jackmday-uofa/compact-shredder-pcb/README.md

# compact-shredder-pcb
PCB schematic and design for the Compact Shredder Design Version 2
