jackmday-uofa/compact-shredder-pcb/shredder_pcb/v1 schematic.pdf

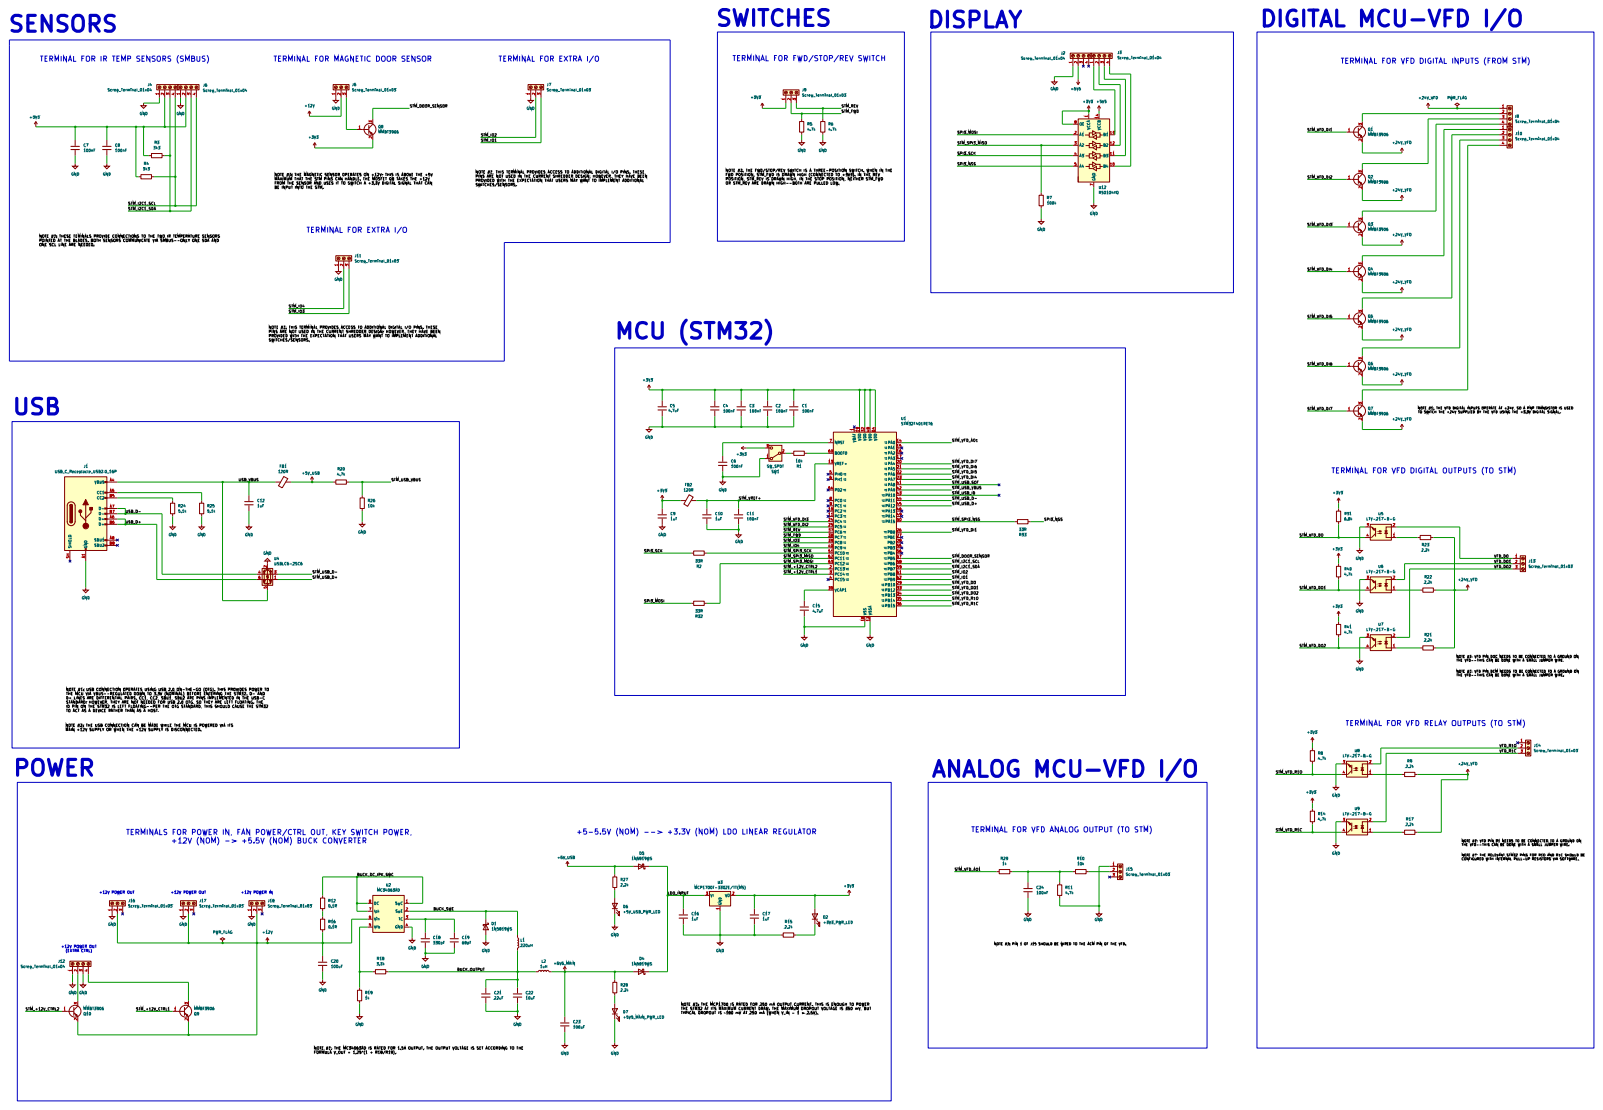
[picture p1: page 1]
