jackmday-uofa/compact-shredder-pcb/shredder_pcb/v1.pdf

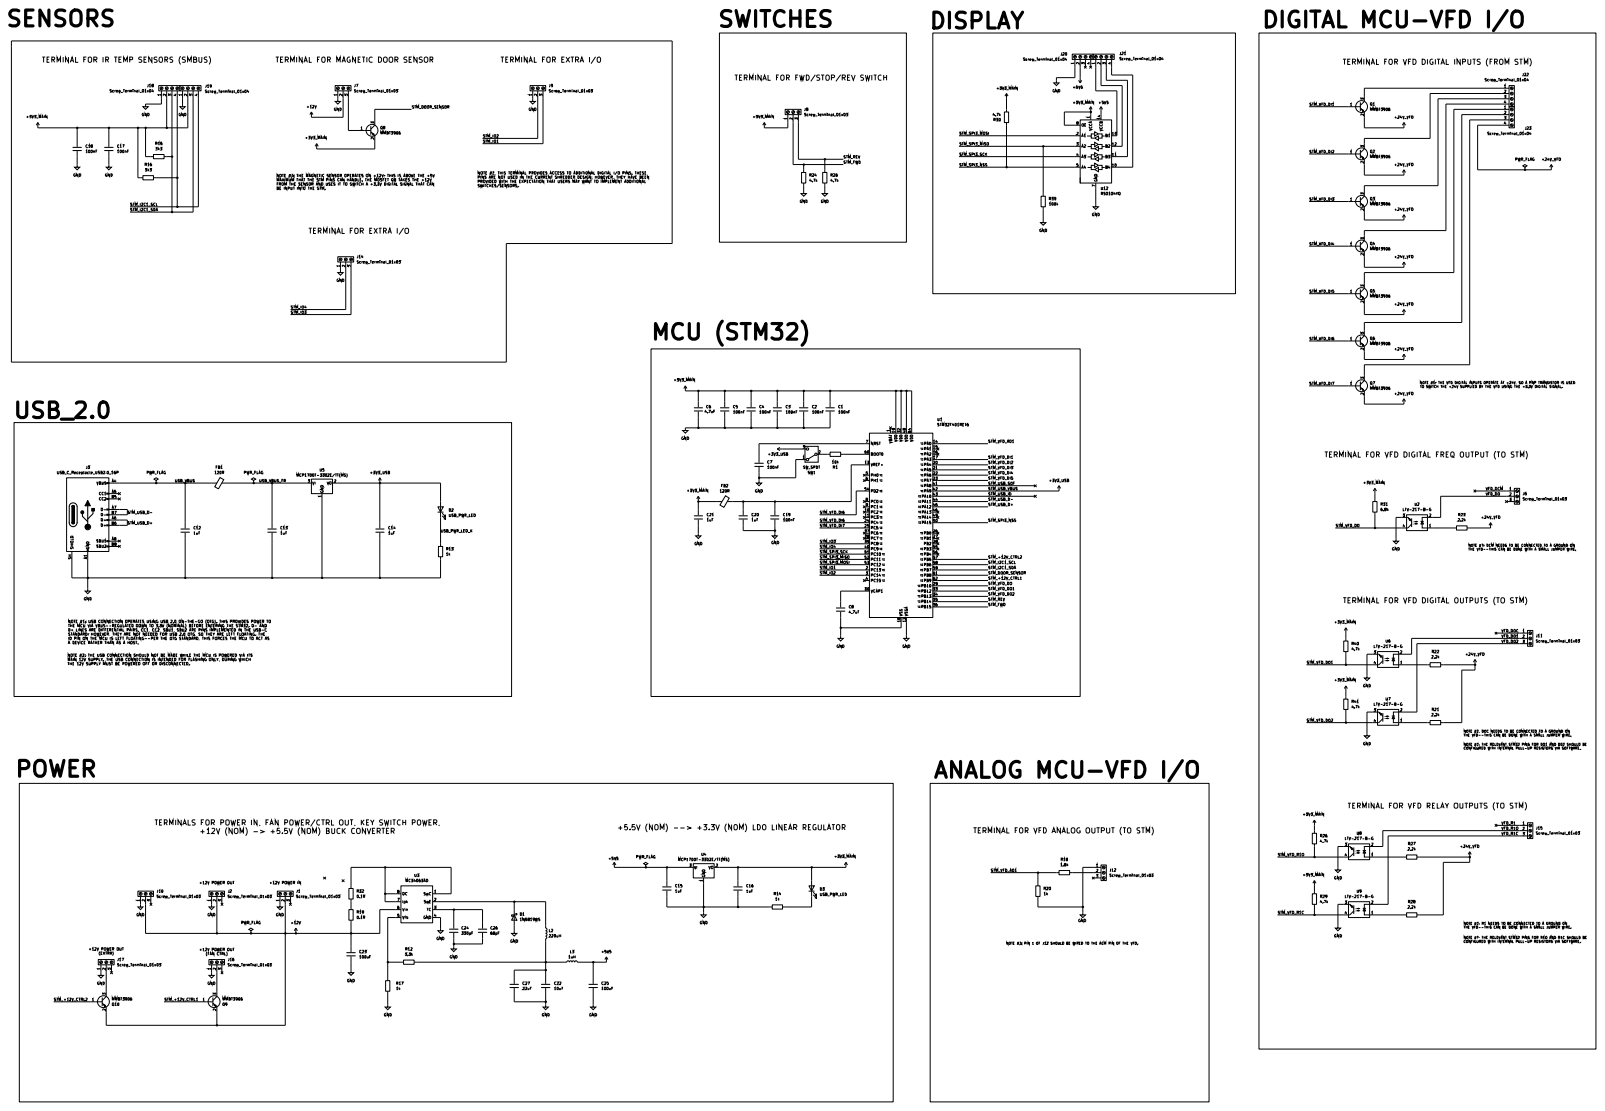
[picture p2: page 1]
