jackmday-uofa/compact-shredder-pcb/shredder_pcb/shredder_pcb.kicad_pcb

## KiCad design shredder_pcb/shredder_pcb.kicad_pcb (2026-09-24)

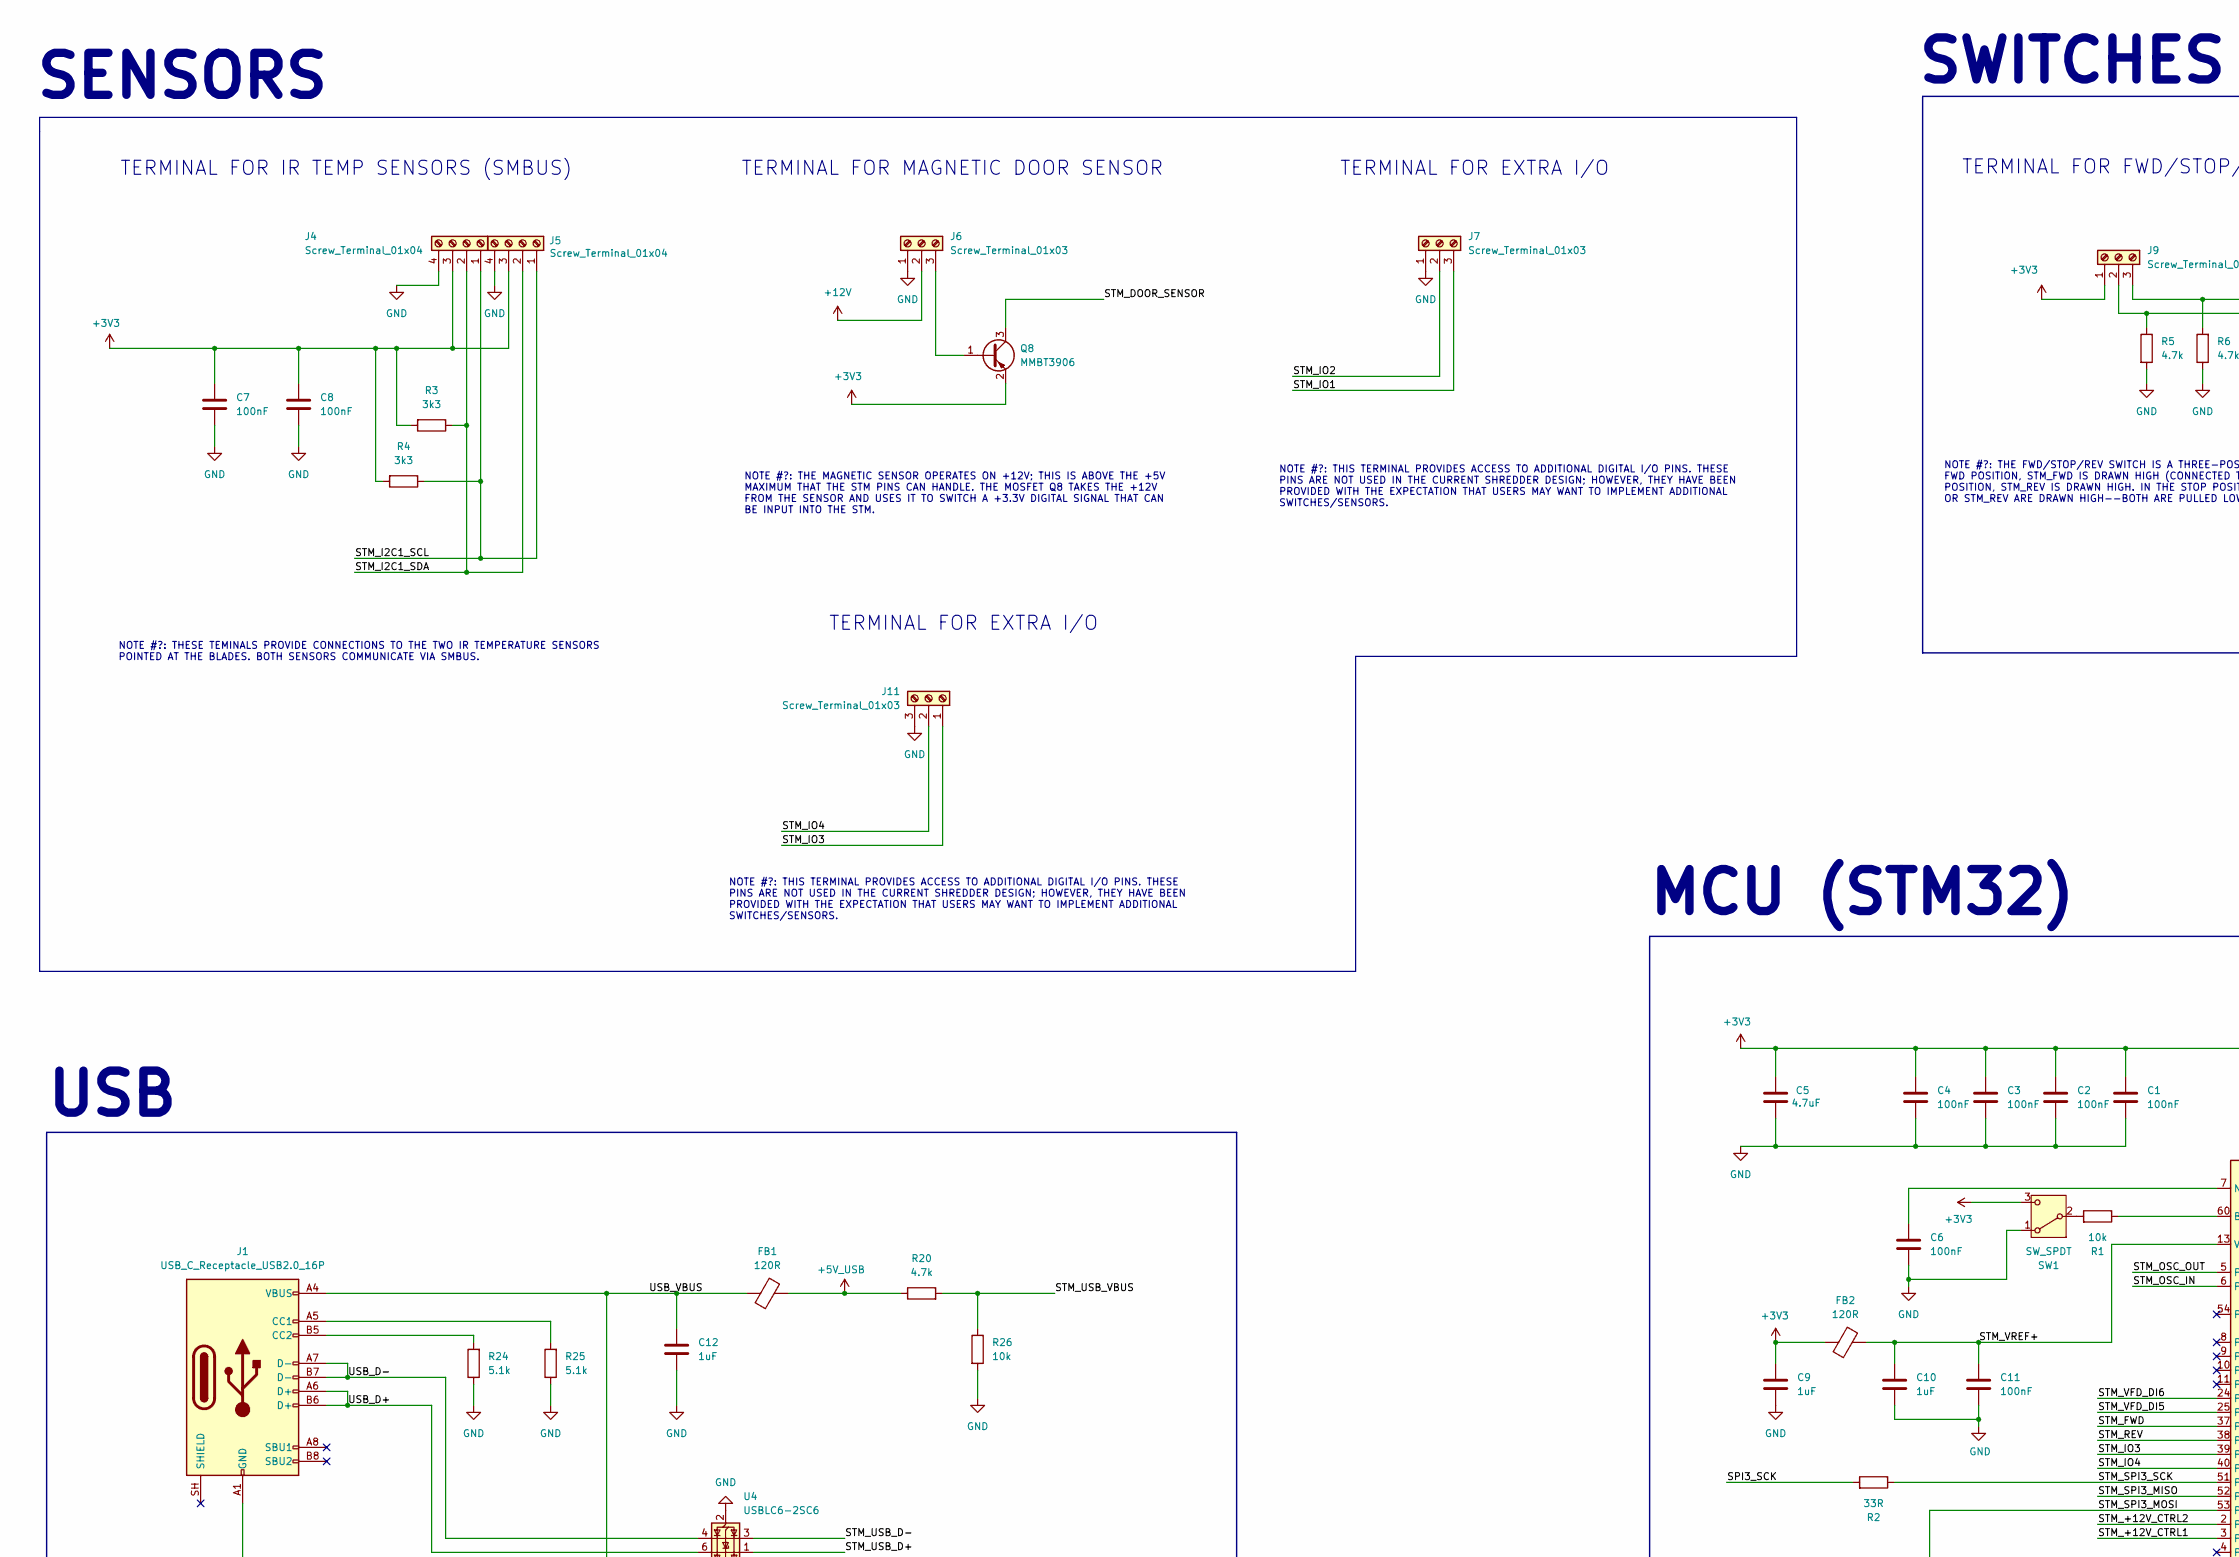
[picture p3: schematic shredder_pcb.kicad_sch, SHREDDER PCB, part in row 1, column 1]

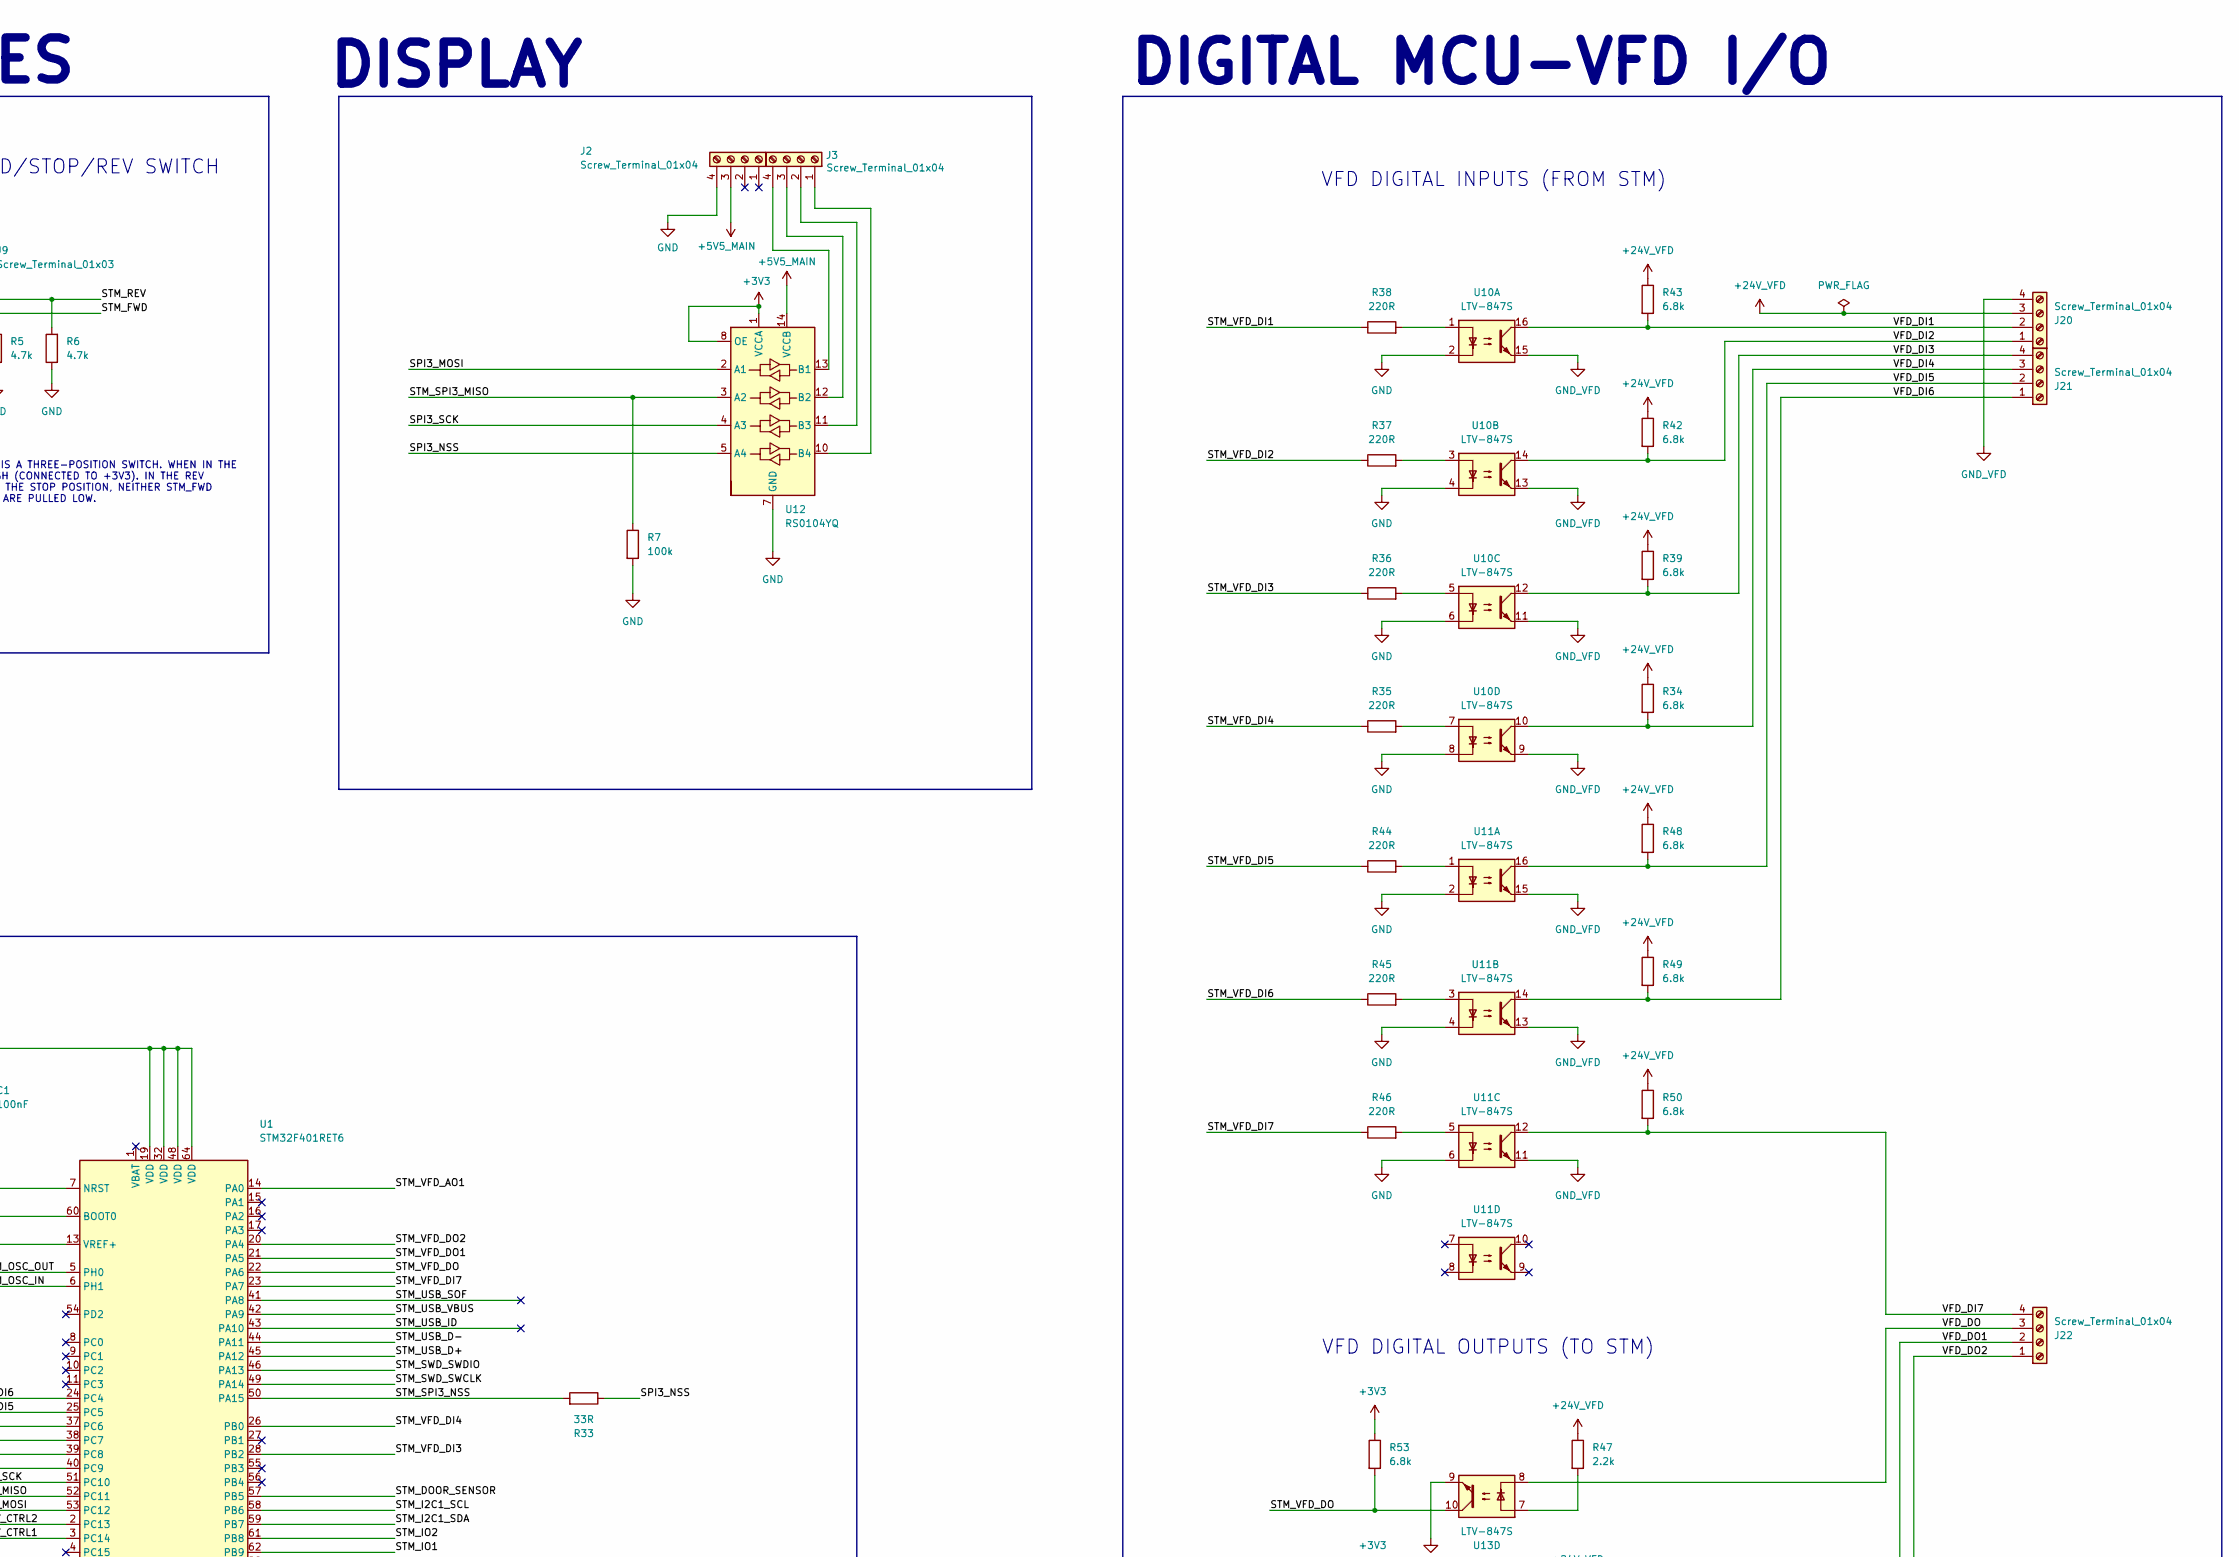
[picture p4: schematic shredder_pcb.kicad_sch, SHREDDER PCB, part in row 1, column 2]

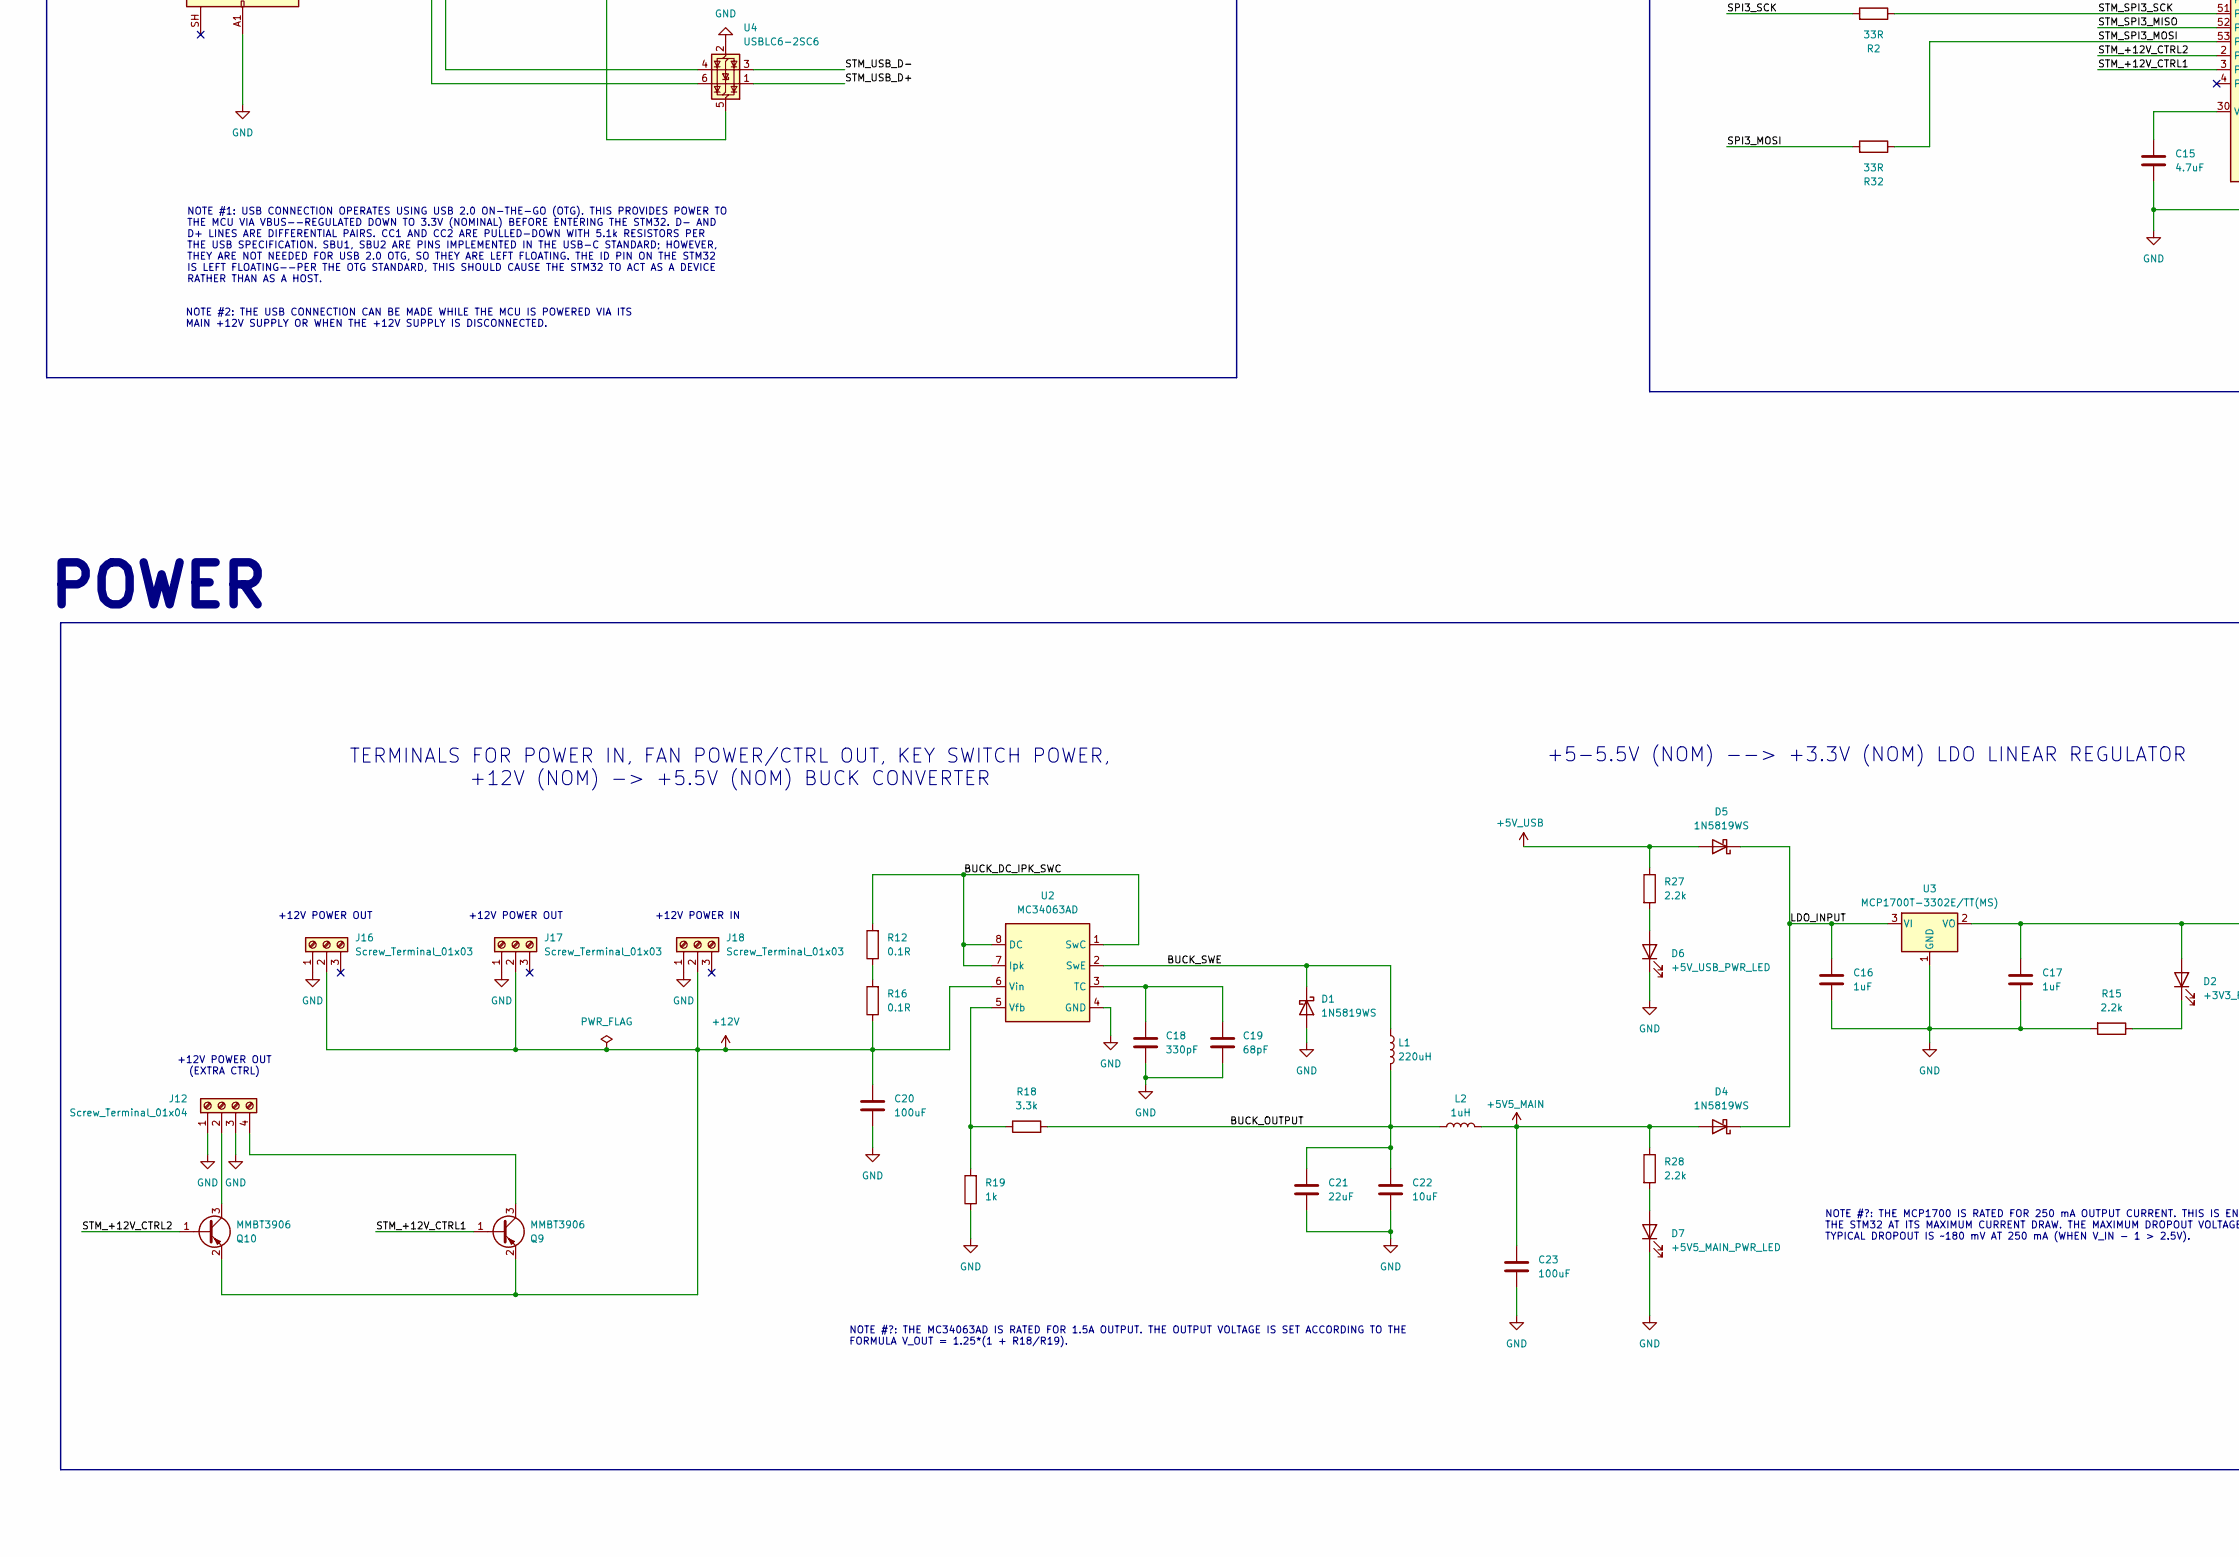
[picture p5: schematic shredder_pcb.kicad_sch, SHREDDER PCB, part in row 2, column 1]

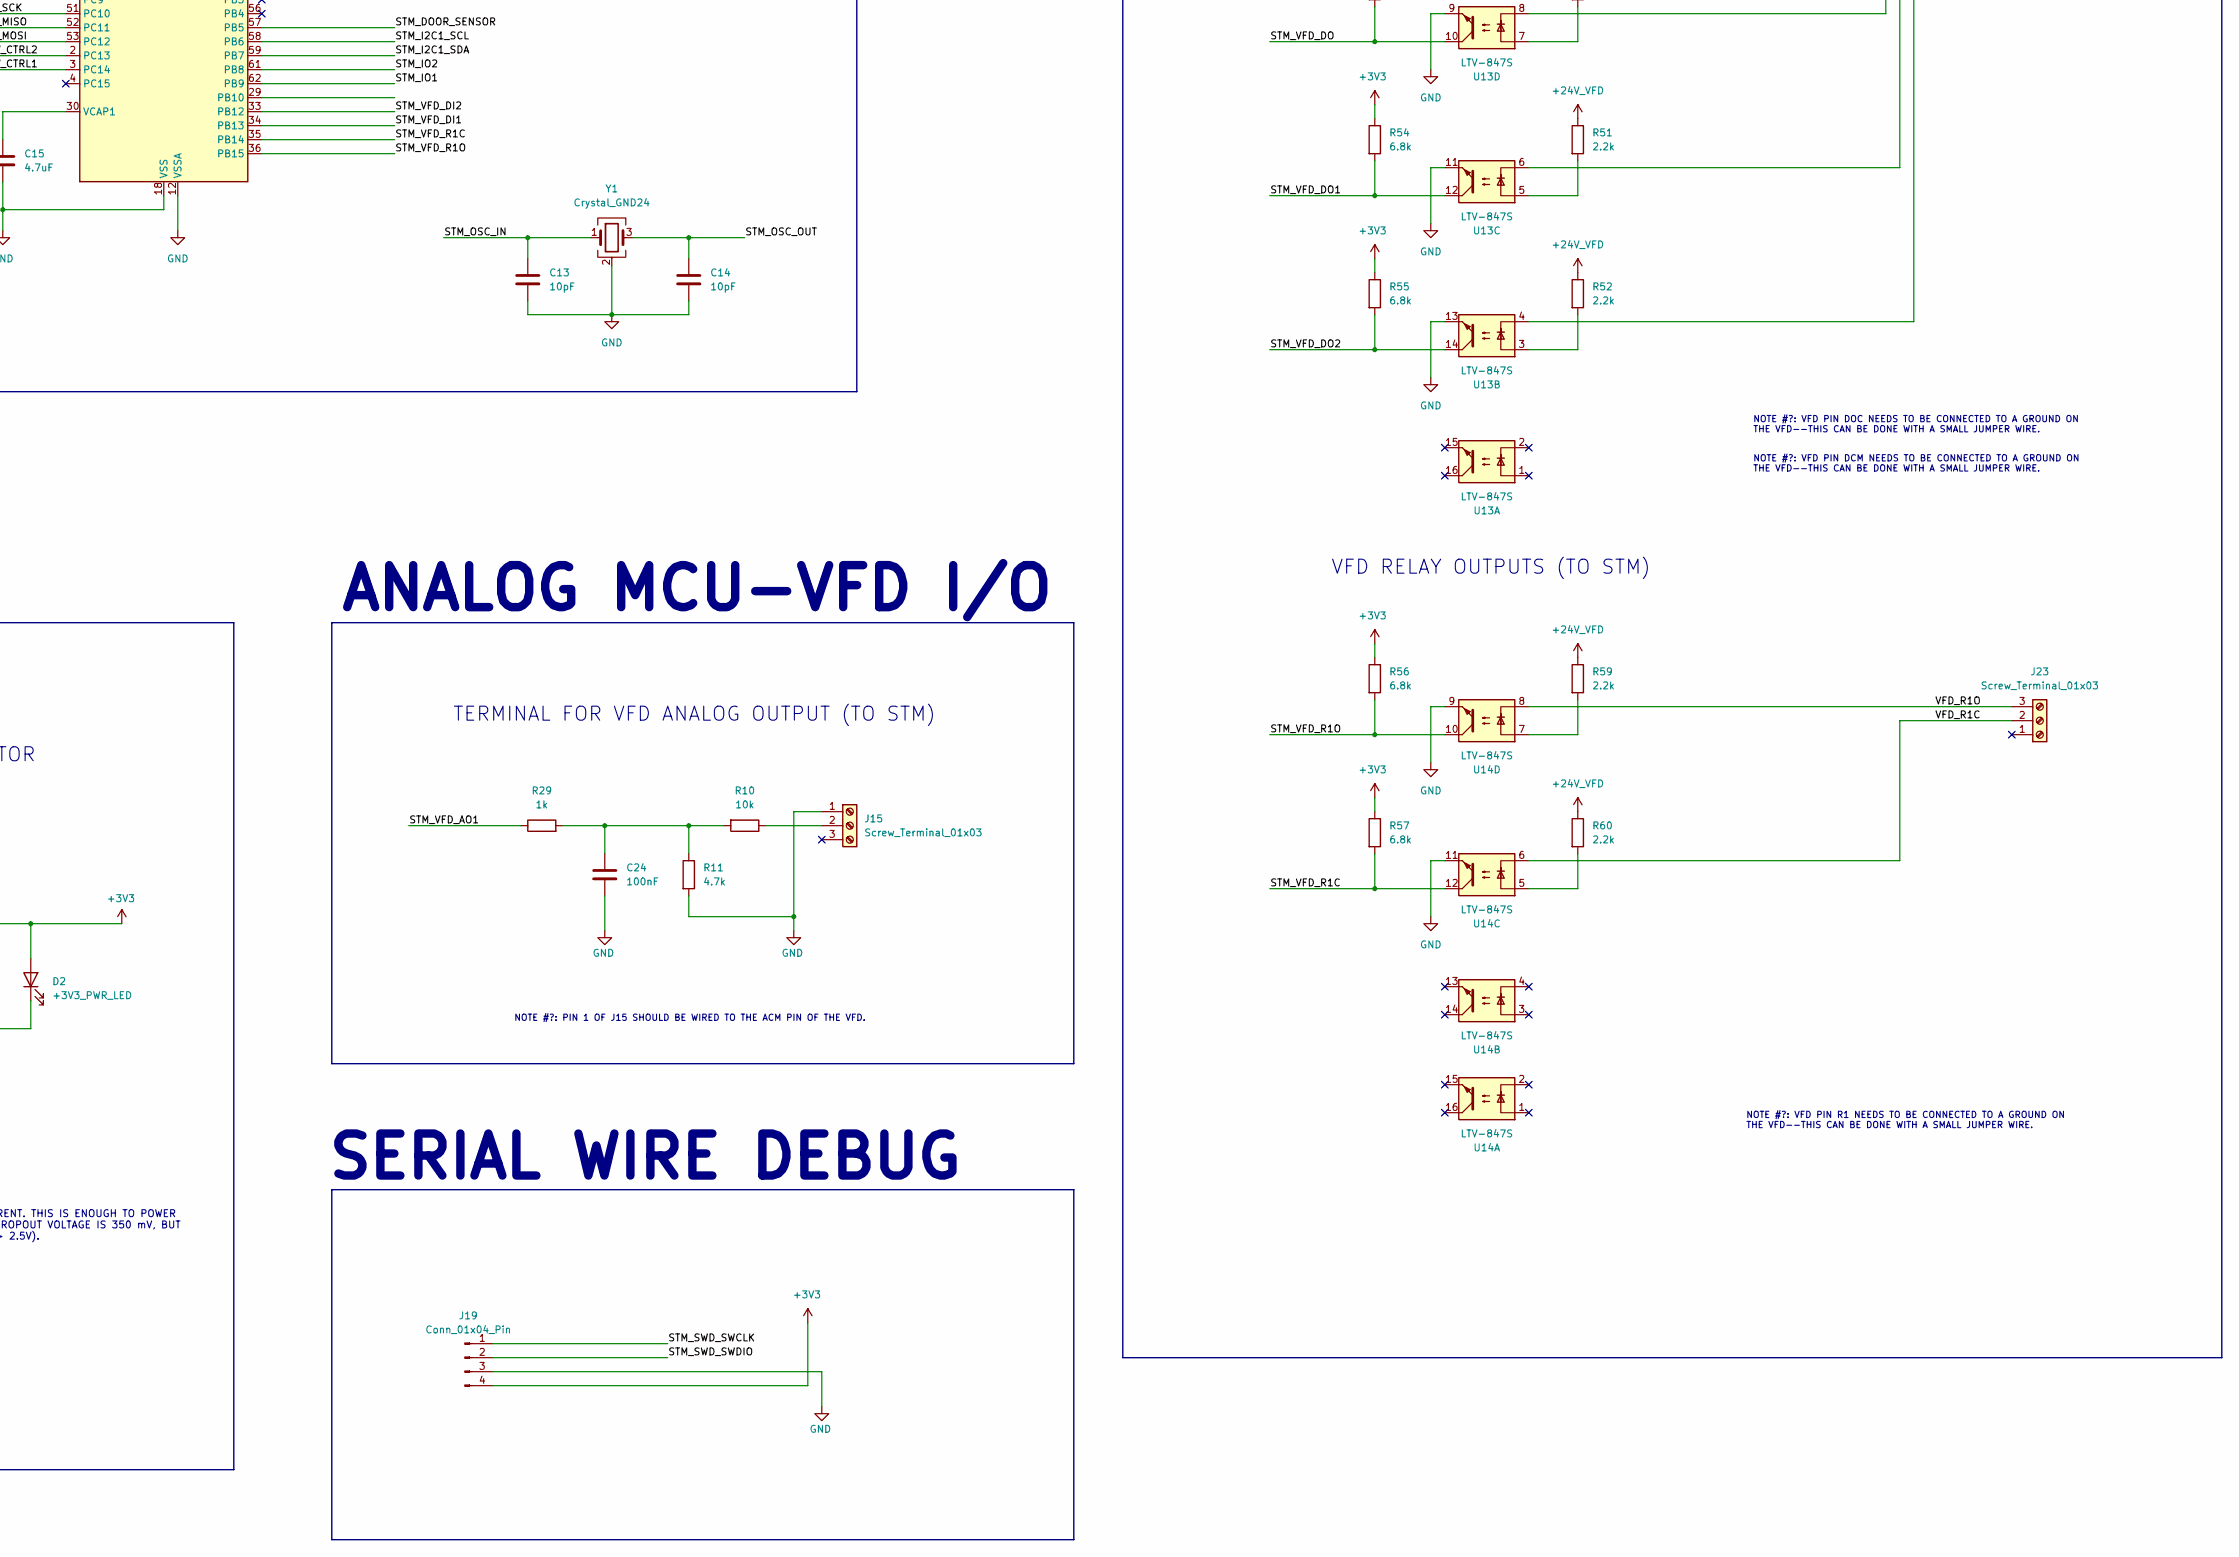
[picture p6: schematic shredder_pcb.kicad_sch, SHREDDER PCB, part in row 2, column 2]

Parts:
C1, C2, C3, C4, C6, C7, C8, C11, C24: 100nF; C_0805_2012Metric
C5, C15: 4.7uF; C_0805_2012Metric
C9, C10, C12, C16, C17: 1uF; C_0805_2012Metric
C13, C14: 10pF; C_0603_1608Metric
C18: 330pF; C_0603_1608Metric
C19: 68pF; C_0603_1608Metric
C20, C23: 100uF; C_1206_3216Metric
C21: 22uF; C_1206_3216Metric
C22: 10uF; C_0805_2012Metric
D1, D4, D5: 1N5819WS; D_SOD-323
D2: +3V3_PWR_LED; LED_0603_1608Metric
D6: +5V_USB_PWR_LED; LED_0603_1608Metric
D7: +5V5_MAIN_PWR_LED; LED_0603_1608Metric
FB1, FB2: 120R; L_0805_2012Metric
J1: USB_C_Receptacle_USB2.0_16P; USB_C_Receptacle_GCT_USB4110
J2, J3, J4, J5, J12, J20, J21, J22: Screw_Terminal_01x04; DB301V-5.0_1x4P
J6, J7, J9, J11, J15, J16, J17, J18, J23: Screw_Terminal_01x03; KF301-5.0_1x3P
J19: Conn_01x04_Pin; PinHeader_1x04_P2.54mm_Vertical
L1: 220uH; L_1210_3225Metric
L2: 1uH; L_0805_2012Metric
Q8, Q9, Q10: MMBT3906; SOT-23-3
R1, R10, R26: 10k; R_0603_1608Metric
R2, R32, R33: 33R; R_0805_2012Metric
R3, R4: 3k3; R_0603_1608Metric
R5, R6, R11, R20: 4.7k; R_0603_1608Metric
R7: 100k; R_0603_1608Metric
R12, R16: 0.1R; R_1206_3216Metric
R15, R27, R28, R47, R51, R52, R59, R60: 2.2k; R_0603_1608Metric
R18: 3.3k; R_0603_1608Metric
R19, R29: 1k; R_0603_1608Metric
R24, R25: 5.1k; R_1206_3216Metric
R34, R39, R42, R43, R48, R49, R50, R53, R54, R55, R56, R57: 6.8k; R_0603_1608Metric
R35, R36, R37, R38, R44, R45, R46: 220R; R_0603_1608Metric
SW1: SW_SPDT; SW_SPDT_Shouhan_MSK12C02
U1: STM32F401RET6; LQFP-64_10x10mm_P0.5mm
U2: MC34063AD; SOIC-8_3.9x4.9mm_P1.27mm
U3: MCP1700T-3302E/TT(MS); SOT-23
U4: USBLC6-2SC6; SOT-23-6
U10, U11, U13, U14: LTV-847S; SMDIP-16_W9.53mm
U12: RS0104YQ; TSSOP-14_4.4x5mm_P0.65mm
Y1: Crystal_GND24; Crystal_SMD_3225-4Pin_3.2x2.5mm

Connections:
+3V3: C1.1, C2.1, C3.1, C4.1, C5.1, C7.1, C8.1, C9.1, C17.1, D2.2 (A), FB2.1, J4.3, J5.3, J9.1, J19.4, Q8.2 (E), R3.2, R4.2, R53.1, R54.1, R55.1, R56.1, R57.1, SW1.3 (C), U1.19 (VDD), U1.32 (VDD), U1.48 (VDD), U1.64 (VDD), U3.2 (VO), U12.1 (VCCA), U12.8 (OE)
+5V5_MAIN: C23.2, D4.2 (A), J2.3, L2.2, R28.1, U12.14 (VCCB)
+5V_USB: D5.2 (A), FB1.2, R20.1, R27.1
+12V: C20.2, J6.2, J16.2, J17.2, J18.2, Q9.2 (E), Q10.2 (E), R16.1, U2.6 (Vin)
+24V_VFD: J20.3, R34.1, R39.1, R42.1, R43.1, R47.1, R48.1, R49.1, R50.1, R51.1, R52.1, R59.1, R60.1
/Root/BUCK_DC_IPK_SWC: R12.2, U2.1 (SwC), U2.7 (Ipk), U2.8 (DC)
/Root/BUCK_OUTPUT: C21.2, C22.2, L1.2, L2.1, R18.2
/Root/BUCK_SWE: D1.1 (K), L1.1, U2.2 (SwE)
/Root/LDO_INPUT: C16.1, D4.1 (K), D5.1 (K), U3.3 (VI)
/Root/SPI3_MOSI: R32.2, U12.2 (A1)
/Root/SPI3_NSS: R33.1, U12.5 (A4)
/Root/SPI3_SCK: R2.2, U12.4 (A3)
/Root/STM_+12V_CTRL1: Q9.1 (B), U1.3 (PC14)
/Root/STM_+12V_CTRL2: Q10.1 (B), U1.2 (PC13)
/Root/STM_DOOR_SENSOR: Q8.3 (C), U1.57 (PB5)
/Root/STM_FWD: J9.2, R5.1, U1.37 (PC6)
/Root/STM_I2C1_SCL: J4.1, J5.1, R4.1, U1.58 (PB6)
/Root/STM_I2C1_SDA: J4.2, J5.2, R3.1, U1.59 (PB7)
/Root/STM_IO1: J7.3, U1.62 (PB9)
/Root/STM_IO2: J7.2, U1.61 (PB8)
/Root/STM_IO3: J11.1, U1.39 (PC8)
/Root/STM_IO4: J11.2, U1.40 (PC9)
/Root/STM_OSC_IN: C13.1, U1.6 (PH1), Y1.1
/Root/STM_OSC_OUT: C14.1, U1.5 (PH0), Y1.3
/Root/STM_REV: J9.3, R6.2, U1.38 (PC7)
/Root/STM_SPI3_MISO: R7.1, U1.52 (PC11), U12.3 (A2)
/Root/STM_SPI3_MOSI: R32.1, U1.53 (PC12)
/Root/STM_SPI3_NSS: R33.2, U1.50 (PA15)
/Root/STM_SPI3_SCK: R2.1, U1.51 (PC10)
/Root/STM_SWD_SWCLK: J19.1, U1.49 (PA14)
/Root/STM_SWD_SWDIO: J19.2, U1.46 (PA13)
/Root/STM_USB_D+: U1.45 (PA12), U4.1 (I/O1)
/Root/STM_USB_D-: U1.44 (PA11), U4.3 (I/O2)
/Root/STM_USB_ID: U1.43 (PA10)
/Root/STM_USB_SOF: U1.41 (PA8)
/Root/STM_USB_VBUS: R20.2, R26.1, U1.42 (PA9)
/Root/STM_VFD_AO1: R29.1, U1.14 (PA0)
/Root/STM_VFD_DI1: R38.1, U1.34 (PB13)
/Root/STM_VFD_DI2: R37.1, U1.33 (PB12)
/Root/STM_VFD_DI3: R36.1, U1.28 (PB2)
/Root/STM_VFD_DI4: R35.1, U1.26 (PB0)
/Root/STM_VFD_DI5: R44.1, U1.25 (PC5)
/Root/STM_VFD_DI6: R45.1, U1.24 (PC4)
/Root/STM_VFD_DI7: R46.1, U1.23 (PA7)
/Root/STM_VFD_DO: R53.2, U1.22 (PA6), U13.10
/Root/STM_VFD_DO1: R54.2, U1.21 (PA5), U13.12
/Root/STM_VFD_DO2: R55.2, U1.20 (PA4), U13.14
/Root/STM_VFD_R1C: R57.2, U1.35 (PB14), U14.12
/Root/STM_VFD_R1O: R56.2, U1.36 (PB15), U14.10
/Root/STM_VREF+: C10.1, C11.1, FB2.2, U1.13 (VREF+)
/Root/USB_D+: J1.A6 (D+), J1.B6 (D+), U4.6 (I/O1)
/Root/USB_D-: J1.A7 (D-), J1.B7 (D-), U4.4 (I/O2)
/Root/USB_VBUS: C12.1, FB1.1, J1.A4 (VBUS), J1.A9 (VBUS), J1.B4 (VBUS), J1.B9 (VBUS), U4.5 (VBUS)
/Root/VFD_DI1: J20.2, R43.2, U10.16
/Root/VFD_DI2: J20.1, R42.2, U10.14
/Root/VFD_DI3: J21.4, R39.2, U10.12
/Root/VFD_DI4: J21.3, R34.2, U10.10
/Root/VFD_DI5: J21.2, R48.2, U11.16
/Root/VFD_DI6: J21.1, R49.2, U11.14
/Root/VFD_DI7: J22.4, R50.2, U11.12
/Root/VFD_DO: J22.3, U13.8
/Root/VFD_DO1: J22.2, U13.6
/Root/VFD_DO2: J22.1, U13.4
/Root/VFD_R1C: J23.2, U14.6
/Root/VFD_R1O: J23.3, U14.8
GND: C1.2, C2.2, C3.2, C4.2, C5.2, C6.2, C7.2, C8.2, C9.2, C10.2, C11.2, C12.2, C13.2, C14.2, C15.2, C16.2, C17.2, C18.1, C19.1, C20.1, C21.1, C22.1, C23.1, C24.2, D1.2 (A), D6.1 (K), D7.1 (K), J1.A1 (GND), J1.A12 (GND), J1.B1 (GND), J1.B12 (GND), J2.4, J4.4, J5.4, J6.1, J7.1, J11.3, J12.1, J12.3, J15.1, J16.1, J17.1, J18.1, J19.3, R5.2, R6.1, R7.2, R11.2, R15.2, R19.1, R24.1, R25.1, R26.2, SW1.1 (A), U1.12 (VSSA), U1.18 (VSS), U1.31 (VSS), U1.47 (VSS), U1.63 (VSS), U2.4 (GND), U3.1 (GND), U4.2 (GND), U10.2, U10.4, U10.6, U10.8, U11.2, U11.4, U11.6, U12.7 (GND), U13.9, U13.11, U13.13, U14.9, U14.11, Y1.2 (G), Y1.4 (G)
GND_VFD: J20.4, U10.9, U10.11, U10.13, U10.15, U11.11, U11.13, U11.15
unnamed: C24.1, R10.2, R11.1, R29.2
unnamed: D2.1 (K), R15.1
unnamed: D6.2 (A), R27.2
unnamed: D7.2 (A), R28.2
unnamed: J1.A5 (CC1), R25.2
unnamed: J1.B5 (CC2), R24.2
unnamed: J3.1, U12.10 (B4)
unnamed: J3.2, U12.11 (B3)
unnamed: J3.3, U12.12 (B2)
unnamed: J3.4, U12.13 (B1)
unnamed: J6.3, Q8.1 (B)
unnamed: J12.2, Q10.3 (C)
unnamed: J12.4, Q9.3 (C)
unnamed: J15.2, R10.1
unnamed: R12.1, R16.2
unnamed: R35.2, U10.7
unnamed: R36.2, U10.5
unnamed: R37.2, U10.3
unnamed: R38.2, U10.1
unnamed: R44.2, U11.1
unnamed: R45.2, U11.3
unnamed: R46.2, U11.5
unnamed: R47.2, U13.7
unnamed: R51.2, U13.5
unnamed: R52.2, U13.3
unnamed: R59.2, U14.7
unnamed: R60.2, U14.5
unnamed: R1.2, SW1.2 (B)
unnamed: R1.1, U1.60 (BOOT0)
unnamed: C6.1, U1.7 (NRST)
unnamed: C15.1, U1.30 (VCAP1)
unnamed: C18.2, C19.2, U2.3 (TC)
unnamed: R18.1, R19.2, U2.5 (Vfb)

Notes on the sheet:
+12V POWER IN
TERMINAL FOR EXTRA I/O
VFD DIGITAL OUTPUTS (TO STM)
DIGITAL MCU-VFD I/O
TERMINAL FOR MAGNETIC DOOR SENSOR
+5-5.5V (NOM) --> +3.3V (NOM) LDO LINEAR REGULATOR
NOTE #?: THESE TEMINALS PROVIDE CONNECTIONS TO THE TWO IR TEMPERATURE SENSORS POINTED AT THE BLADES. BOTH SENSORS COMMUNICATE VIA SMBUS.
SERIAL WIRE DEBUG
TERMINAL FOR VFD ANALOG OUTPUT (TO STM)
+12V POWER OUT
VFD RELAY OUTPUTS (TO STM)
NOTE #?: THE MAGNETIC SENSOR OPERATES ON +12V; THIS IS ABOVE THE +5V MAXIMUM THAT THE STM PINS CAN HANDLE. THE MOSFET Q8 TAKES THE +12V FROM THE SENSOR AND USES IT TO SWITCH A +3.3V DIGITAL SIGNAL THAT CAN BE INPUT INTO THE STM.
NOTE #?: VFD PIN DOC NEEDS TO BE CONNECTED TO A GROUND ON THE VFD--THIS CAN BE DONE WITH A SMALL JUMPER WIRE.
SENSORS
TERMINALS FOR POWER IN, FAN POWER/CTRL OUT, KEY SWITCH POWER, +12V (NOM) -> +5.5V (NOM) BUCK CONVERTER
MCU (STM32)
NOTE #?: THIS TERMINAL PROVIDES ACCESS TO ADDITIONAL DIGITAL I/O PINS. THESE PINS ARE NOT USED IN THE CURRENT SHREDDER DESIGN; HOWEVER, THEY HAVE BEEN PROVIDED WITH THE EXPECTATION THAT USERS MAY WANT TO IMPLEMENT ADDITIONAL SWITCHES/SENSORS.
ANALOG MCU-VFD I/O
NOTE #2: THE USB CONNECTION CAN BE MADE WHILE THE MCU IS POWERED VIA ITS MAIN +12V SUPPLY OR WHEN THE +12V SUPPLY IS DISCONNECTED.
DISPLAY
NOTE #?: VFD PIN R1 NEEDS TO BE CONNECTED TO A GROUND ON THE VFD--THIS CAN BE DONE WITH A SMALL JUMPER WIRE.
TERMINAL FOR FWD/STOP/REV SWITCH
USB
NOTE #1: USB CONNECTION OPERATES USING USB 2.0 ON-THE-GO (OTG). THIS PROVIDES POWER TO THE MCU VIA VBUS--REGULATED DOWN TO 3.3V (NOMINAL) BEFORE ENTERING THE STM32. D- AND D+ LINES ARE DIFFERENTIAL PAIRS. CC1 AND CC2 ARE PULLED-DOWN WITH 5.1k RESISTORS PER THE USB SPECIFICATION. SBU1, SBU2 ARE PINS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
VFD DIGITAL INPUTS (FROM STM)
NOTE #?: VFD PIN DCM NEEDS TO BE CONNECTED TO A GROUND ON THE VFD--THIS CAN BE DONE WITH A SMALL JUMPER WIRE.
+12V POWER OUT (EXTRA CTRL)
NOTE #?: THE FWD/STOP/REV SWITCH IS A THREE-POSITION SWITCH. WHEN IN THE FWD POSITION, STM_FWD IS DRAWN HIGH (CONNECTED TO +3V3). IN THE REV POSITION, STM_REV IS DRAWN HIGH. IN THE STOP POSITION, NEITHER STM_FWD OR STM_REV ARE DRAWN HIGH--BOTH ARE PULLED LOW.
NOTE #?: THE MC34063AD IS RATED FOR 1.5A OUTPUT. THE OUTPUT VOLTAGE IS SET ACCORDING TO THE FORMULA V_OUT = 1.25*(1 + R18/R19).
NOTE #?: PIN 1 OF J15 SHOULD BE WIRED TO THE ACM PIN OF THE VFD.
SWITCHES
POWER
TERMINAL FOR IR TEMP SENSORS (SMBUS)
NOTE #?: THE MCP1700 IS RATED FOR 250 mA OUTPUT CURRENT. THIS IS ENOUGH TO POWER THE STM32 AT ITS MAXIMUM CURRENT DRAW. THE MAXIMUM DROPOUT VOLTAGE IS 350 mV, BUT TYPICAL DROPOUT IS ~180 mV AT 250 mA (WHEN V_IN - 1 > 2.5V).

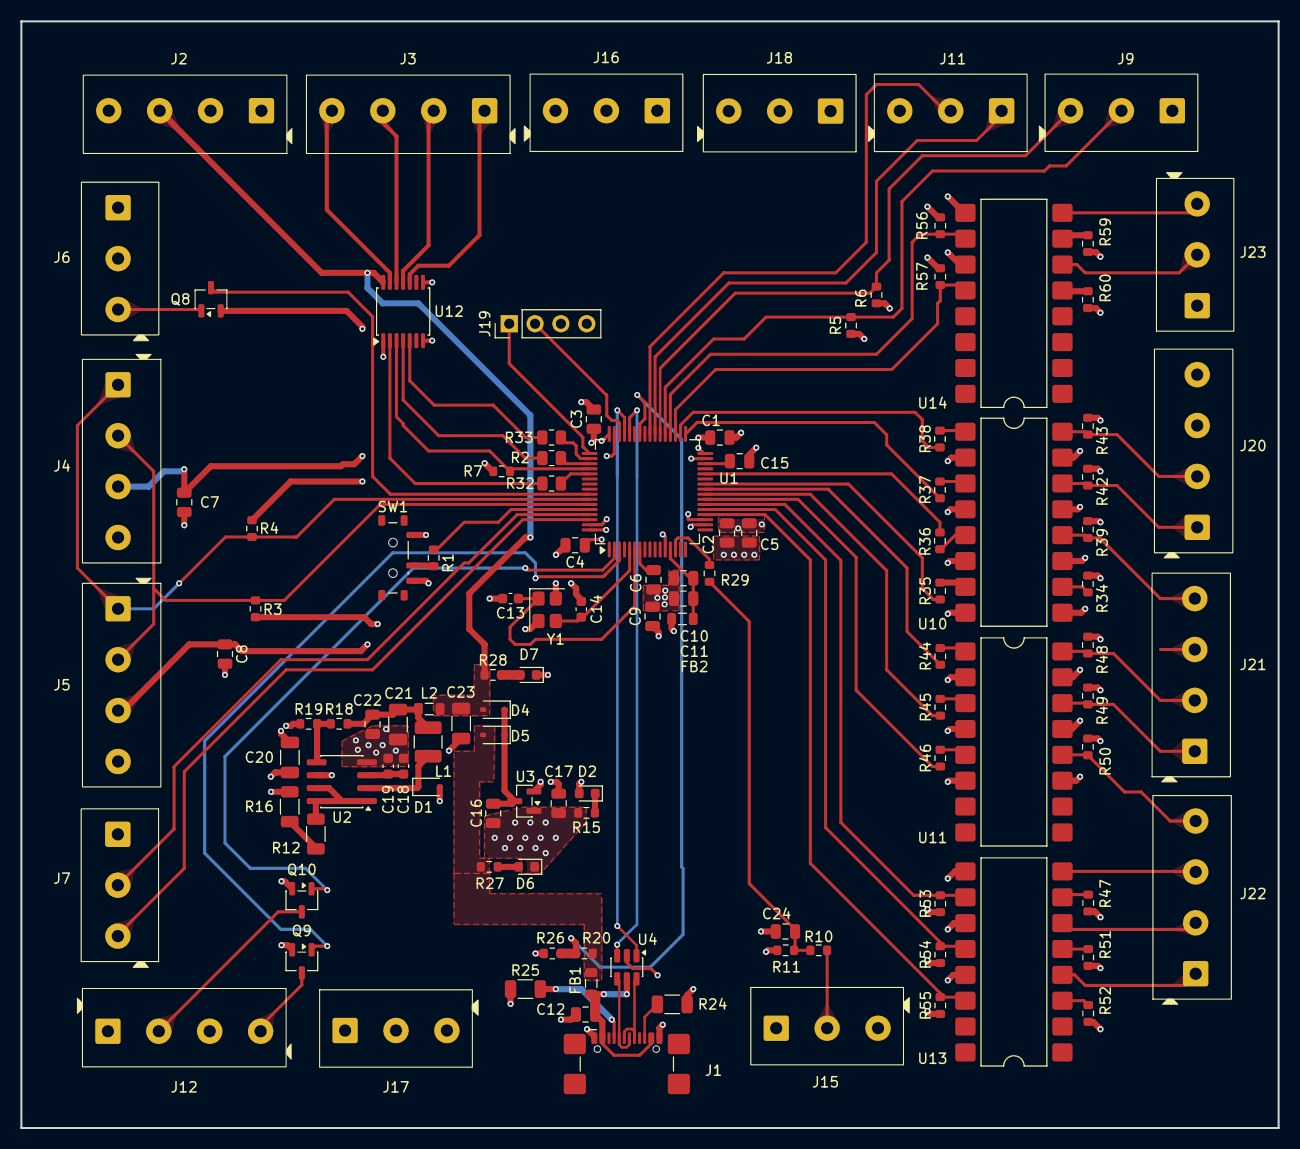
[picture p7: board shredder_pcb.kicad_pcb from above]

Board: 4 copper layers, 123.5 x 108.7 mm, 114 parts (0 on the bottom side), 98 nets.
