jackmday-uofa/compact-shredder-pcb/shredder_pcb/lcd_spi_header_board/lcd_spi_header_board.kicad_pcb

## KiCad design shredder_pcb/lcd_spi_header_board/lcd_spi_header_board.kicad_pcb (2026-09-24)

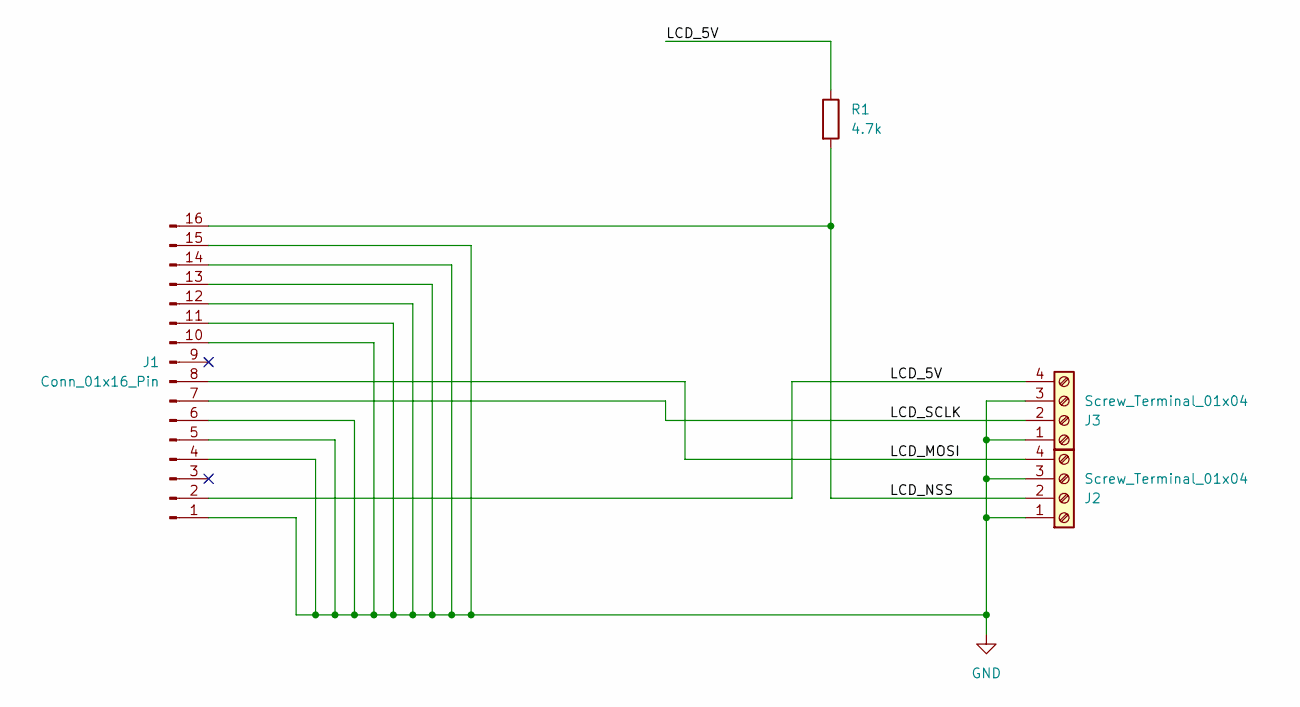
[picture p8: schematic lcd_spi_header_board.kicad_sch, LCD SPI HEADER BOARD]

Parts:
J1: Conn_01x16_Pin; PinSocket_1x16_P2.54mm_Vertical
J2, J3: Screw_Terminal_01x04; DB301V-5.0_1x4P
R1: 4.7k; R_0805_2012Metric

Connections:
/LCD_5V: J1.2, J3.4, R1.1
/LCD_MOSI: J1.8, J2.4
/LCD_NSS: J1.16, J2.2, R1.2
/LCD_SCLK: J1.7, J3.2
GND: J1.1, J1.4, J1.5, J1.6, J1.10, J1.11, J1.12, J1.13, J1.14, J1.15, J2.1, J2.3, J3.1, J3.3

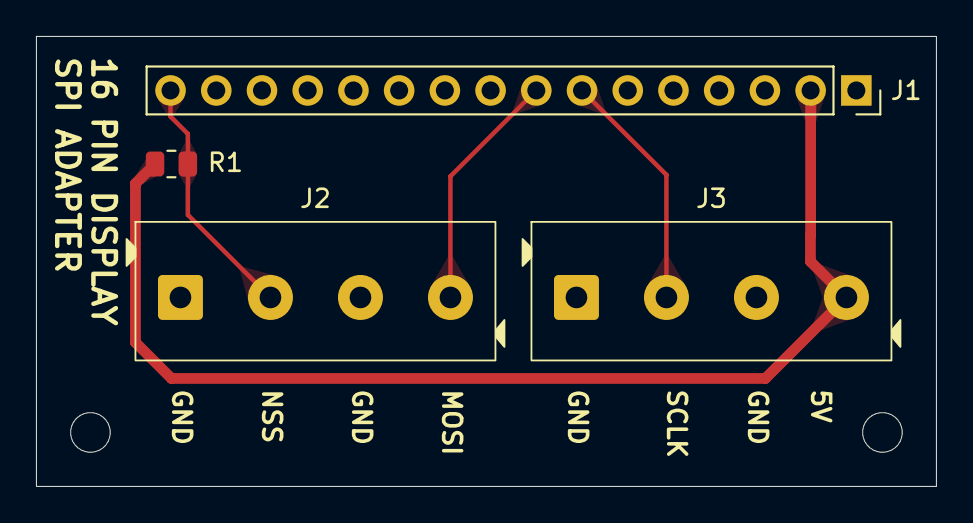
[picture p9: board lcd_spi_header_board.kicad_pcb from above]

Board: 2 copper layers, 50.0 x 25.0 mm, 4 parts (0 on the bottom side), 5 nets.
